Robertleoj/pen_plotter_robot/README.md

# Robotic pen plotter
A hobby project I made, here is a demo video:

demo
