Robertleoj/pen_plotter_robot/media/mks_servo_42c.webp

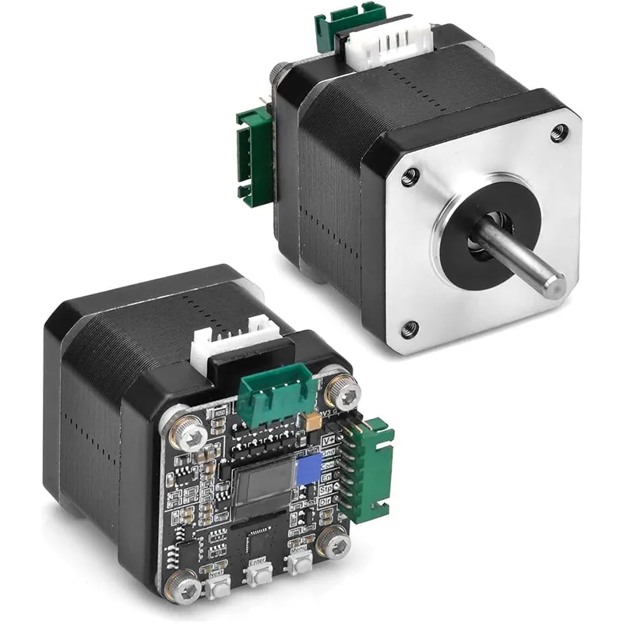
media/mks_servo_42c.webp
